CopperPilot/retro-handheld-copperpilot/case/models/copperpilot_retro_handheld_assembly.stl

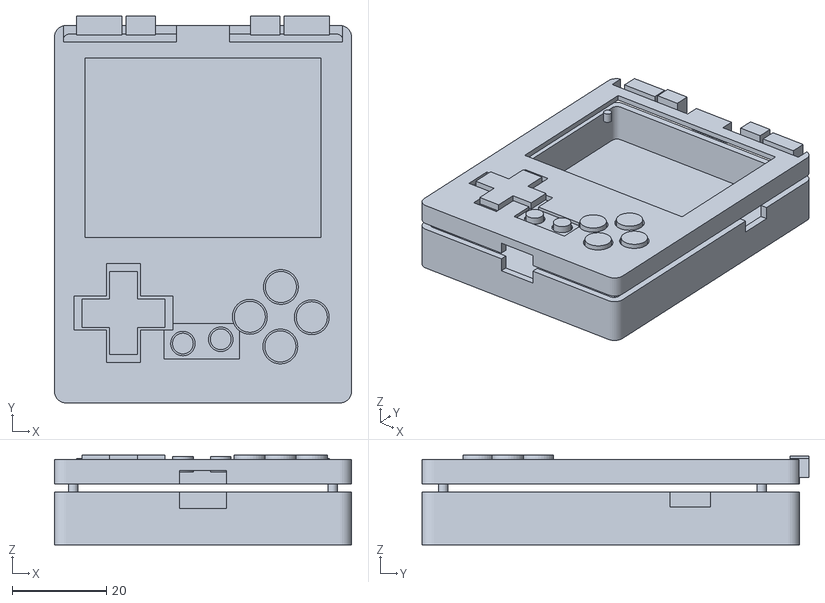
[picture p11: CAD file, 2026-10-24]
case/models/copperpilot_retro_handheld_assembly.stl
63.0 x 82.0 x 19.0
