CopperPilot/retro-handheld-copperpilot/case/models/copperpilot_retro_handheld_pcb_populated.step

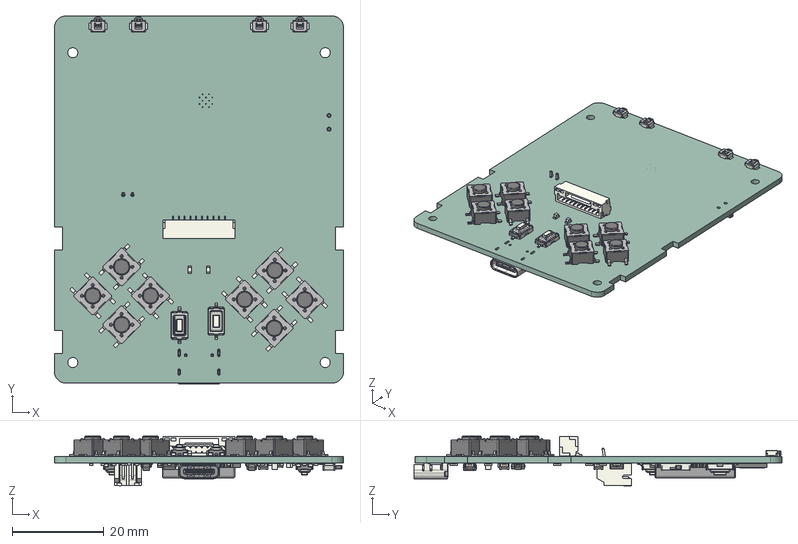
[picture p12: CAD file, 2026-10-24]
case/models/copperpilot_retro_handheld_pcb_populated.step
63.0 x 80.2 x 10.8 mm
SW_SPST_PTS645Sx43SMTR92 x 8
LED_0603_1608Metric x 2
SW_SPST_B3U-3000P x 4
JST_SM10B_GHS_TB
PTS636Sx25SMTRLFS x 4
C_0603_1608Metric x 9
R_0603_1608Metric x 29
C_0805_2012Metric x 6
R_0805_2012Metric
SOT-23 x 2
D_SOD-123
SOT-23-5 x 2
USB_C_Receptacle_16P_TopMnt_Horizontal_GCT_USB4105-xx-A
SOT-23-6
JST_S2B_PH_K
ESP32-S3-WROOM-1
Fusion_sp
copperpilot-retro-handheld_PCB
