CopperPilot/retro-handheld-copperpilot/case/models/buttons_dpad_abxy_sest_shoulders.stl

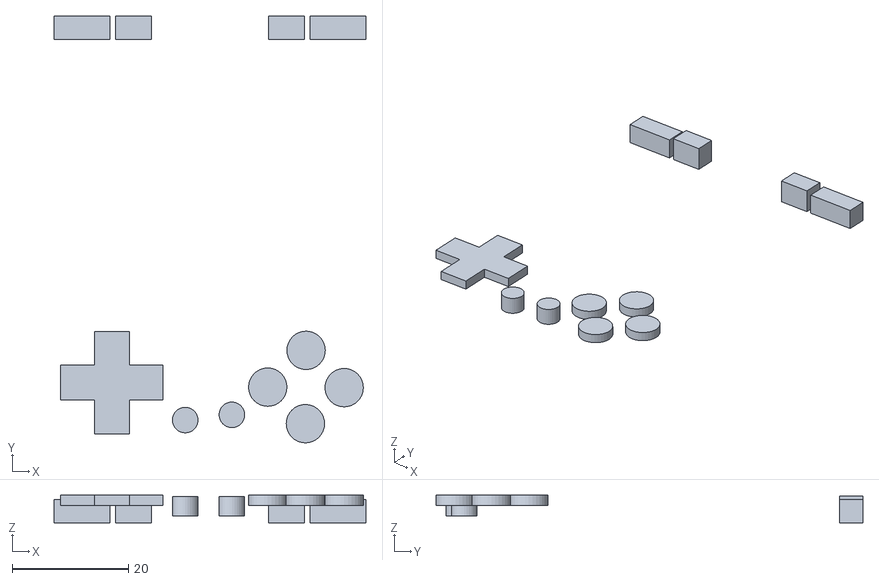
[picture p13: CAD file, 2026-10-24]
case/models/buttons_dpad_abxy_sest_shoulders.stl
53.6 x 73.3 x 4.75
