CopperPilot/retro-handheld-copperpilot/case/models/case_rear_grooved.stl

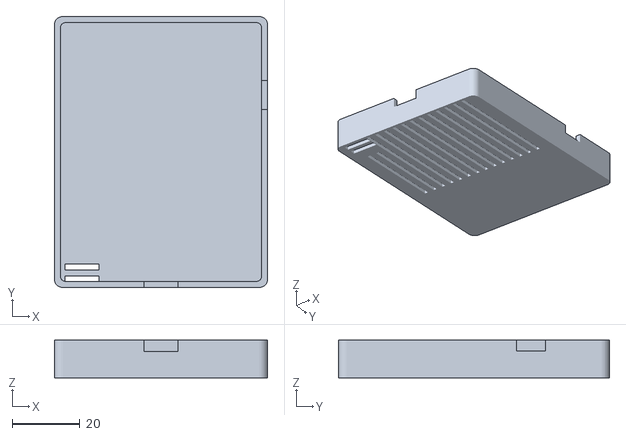
[picture p14: CAD file, 2026-10-24]
case/models/case_rear_grooved.stl
63.0 x 80.0 x 11.2
