CopperPilot/retro-handheld-copperpilot/case/models/case_battery_door.stl

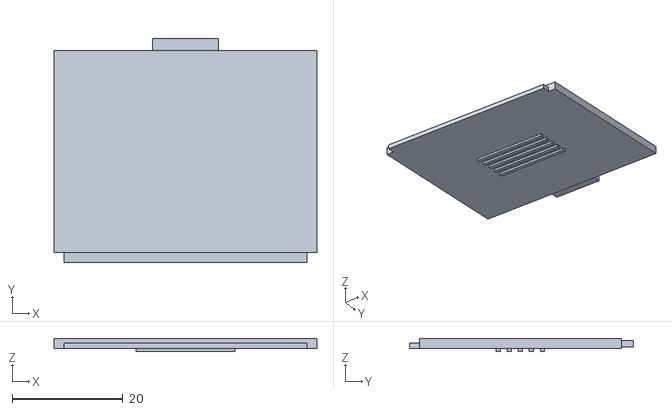
[picture p15: CAD file, 2026-10-24]
case/models/case_battery_door.stl
47.6 x 40.6 x 2.30
