CopperPilot/retro-handheld-copperpilot/case/models/case_front_bezel.stl

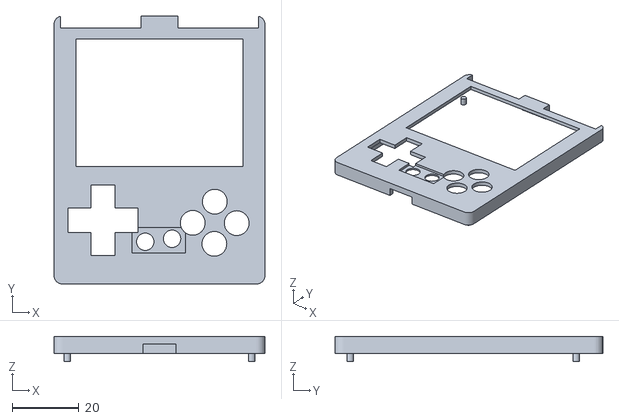
[picture p16: CAD file, 2026-10-24]
case/models/case_front_bezel.stl
63.0 x 80.0 x 7.60
