CopperPilot/retro-handheld-copperpilot/(list of files, cad)

Other CAD files:
case/models/gameboy_pcb_populated.step
case/models/copperpilot_retro_handheld_pcb_populated.stl
