CopperPilot/retro-handheld-copperpilot/copperpilot-retro-handheld.kicad_pcb

## KiCad design copperpilot-retro-handheld.kicad_pcb (2026-10-24)

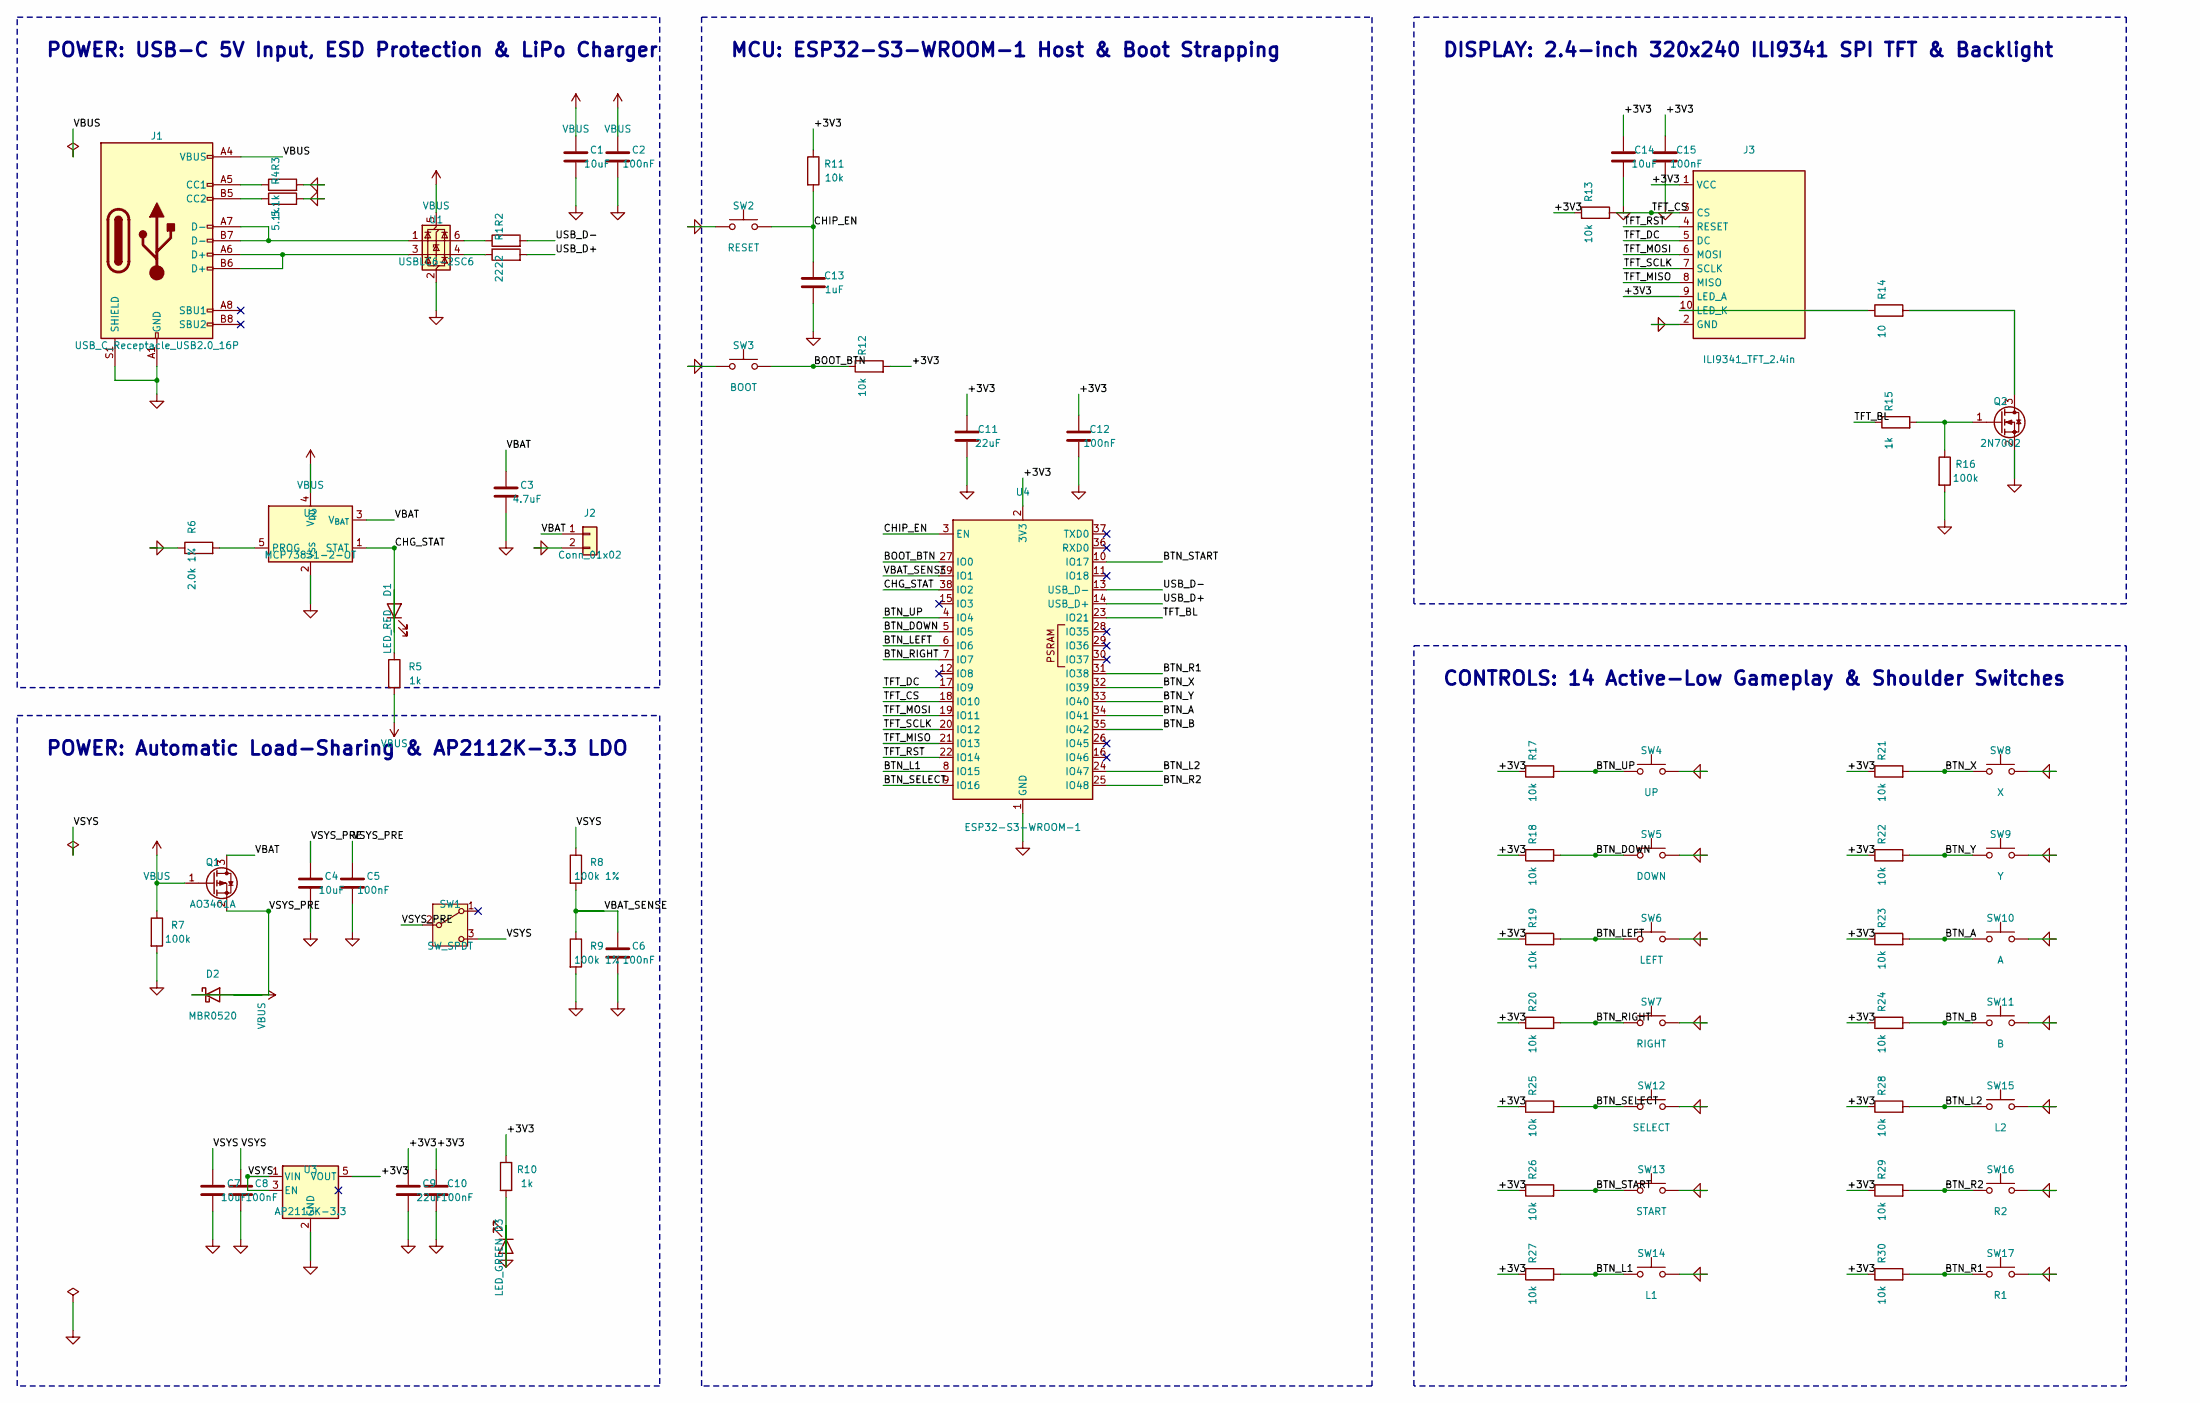
[picture p17: schematic copperpilot-retro-handheld.kicad_sch, ESP32-S3 Handheld Console]

Parts:
C1, C4, C7, C14: 10uF; C_0805_2012Metric
C2, C5, C6, C8, C10, C12, C15: 100nF; C_0603_1608Metric
C3: 4.7uF; C_0603_1608Metric
C9, C11: 22uF; C_0805_2012Metric
C13: 1uF; C_0603_1608Metric
D1: LED_RED; LED_0603_1608Metric
D2: MBR0520; D_SOD-123
D3: LED_GREEN; LED_0603_1608Metric
J1: USB_C_Receptacle_USB2.0_16P; USB_C_Receptacle_GCT_USB4105-xx-A_16P_TopMnt_Horizontal
J2: Conn_01x02; JST_PH_S2B-PH-K_1x02_P2.00mm_Horizontal
J3: ILI9341_TFT_2.4in; ILI9341_TFT_2.4in_10P
Q1: AO3401A; SOT-23
Q2: 2N7002; SOT-23
R1, R2: 22; R_0603_1608Metric
R3, R4: 5.1k; R_0603_1608Metric
R5, R10, R15: 1k; R_0603_1608Metric
R6: 2.0k 1%; R_0603_1608Metric
R7, R16: 100k; R_0603_1608Metric
R8, R9: 100k 1%; R_0603_1608Metric
R11, R12, R13, R17, R18, R19, R20, R21, R22, R23, R24, R25, R26, R27, R28, R29, R30: 10k; R_0603_1608Metric
R14: 10; R_0805_2012Metric
SW1: SW_SPDT; SW_SPDT_PCM12
SW2: RESET; SW_Tactile_SPST_NO_Straight_CK_PTS636Sx25SMTRLFS
SW3: BOOT; SW_Tactile_SPST_NO_Straight_CK_PTS636Sx25SMTRLFS
SW4: UP; SW_SPST_PTS645Sx43SMTR92
SW5: DOWN; SW_SPST_PTS645Sx43SMTR92
SW6: LEFT; SW_SPST_PTS645Sx43SMTR92
SW7: RIGHT; SW_SPST_PTS645Sx43SMTR92
SW8: X; SW_SPST_PTS645Sx43SMTR92
SW9: Y; SW_SPST_PTS645Sx43SMTR92
SW10: A; SW_SPST_PTS645Sx43SMTR92
SW11: B; SW_SPST_PTS645Sx43SMTR92
SW12: SELECT; SW_Tactile_SPST_NO_Straight_CK_PTS636Sx25SMTRLFS
SW13: START; SW_Tactile_SPST_NO_Straight_CK_PTS636Sx25SMTRLFS
SW14: L1; SW_SPST_B3U-3000P
SW15: L2; SW_SPST_B3U-3000P
SW16: R2; SW_SPST_B3U-3000P
SW17: R1; SW_SPST_B3U-3000P
U1: USBLC6-2SC6; SOT-23-6
U2: MCP73831-2-OT; SOT-23-5
U3: AP2112K-3.3; SOT-23-5
U4: ESP32-S3-WROOM-1

Connections:
/+3V3: C9.1, C10.1, C11.1, C12.1, C14.1, C15.1, J3.1 (VCC), J3.9 (LED_A), R10.1, R11.1, R12.2, R13.1, R17.1, R18.1, R19.1, R20.1, R21.1, R22.1, R23.1, R24.1, R25.1, R26.1, R27.1, R28.1, R29.1, R30.1, U3.5 (VOUT), U4.2 (3V3)
/BOOT_BTN: R12.1, SW3.2, U4.27 (IO0)
/BTN_A: R23.2, SW10.1, U4.34 (IO41)
/BTN_B: R24.2, SW11.1, U4.35 (IO42)
/BTN_DOWN: R18.2, SW5.1, U4.5 (IO5)
/BTN_L1: R27.2, SW14.1, U4.8 (IO15)
/BTN_L2: R28.2, SW15.1, U4.24 (IO47)
/BTN_LEFT: R19.2, SW6.1, U4.6 (IO6)
/BTN_R1: R30.2, SW17.1, U4.31 (IO38)
/BTN_R2: R29.2, SW16.1, U4.25 (IO48)
/BTN_RIGHT: R20.2, SW7.1, U4.7 (IO7)
/BTN_SELECT: R25.2, SW12.1, U4.9 (IO16)
/BTN_START: R26.2, SW13.1, U4.10 (IO17)
/BTN_UP: R17.2, SW4.1, U4.4 (IO4)
/BTN_X: R21.2, SW8.1, U4.32 (IO39)
/BTN_Y: R22.2, SW9.1, U4.33 (IO40)
/CHG_STAT: D1.1 (K), U2.1 (STAT), U4.38 (IO2)
/CHIP_EN: C13.1, R11.2, SW2.2, U4.3 (EN)
/TFT_BL: R15.1, U4.23 (IO21)
/TFT_CS: J3.3 (CS), R13.2, U4.18 (IO10)
/TFT_DC: J3.5 (DC), U4.17 (IO9)
/TFT_MISO: J3.8 (MISO), U4.21 (IO13)
/TFT_MOSI: J3.6 (MOSI), U4.19 (IO11)
/TFT_RST: J3.4 (RESET), U4.22 (IO14)
/TFT_SCLK: J3.7 (SCLK), U4.20 (IO12)
/USB_D+: R1.2, U4.14 (USB_D+)
/USB_D-: R2.2, U4.13 (USB_D-)
/VBAT: C3.1, J2.1, Q1.3 (D), U2.3 (V_{BAT})
/VBAT_SENSE: C6.1, R8.2, R9.1, U4.39 (IO1)
/VSYS: C7.1, C8.1, R8.1, SW1.3 (C), U3.1 (VIN), U3.3 (EN)
unnamed: D1.2 (A), R5.1
unnamed: J1.A5 (CC1), R3.1
unnamed: J1.B5 (CC2), R4.1
unnamed: J1.A6 (D+), J1.B6 (D+), U1.3 (I/O2)
unnamed: J1.A7 (D-), J1.B7 (D-), U1.1 (I/O1)
unnamed: J3.10 (LED_K), R14.1
unnamed: Q2.3 (D), R14.2
unnamed: Q2.1 (G), R15.2, R16.1
unnamed: R1.1, U1.4 (I/O2)
unnamed: R2.1, U1.6 (I/O1)
unnamed: R6.2, U2.5 (PROG)

Notes on the sheet:
POWER: USB-C 5V Input, ESD Protection & LiPo Charger
POWER: Automatic Load-Sharing & AP2112K-3.3 LDO
MCU: ESP32-S3-WROOM-1 Host & Boot Strapping
DISPLAY: 2.4-inch 320x240 ILI9341 SPI TFT & Backlight
CONTROLS: 14 Active-Low Gameplay & Shoulder Switches

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
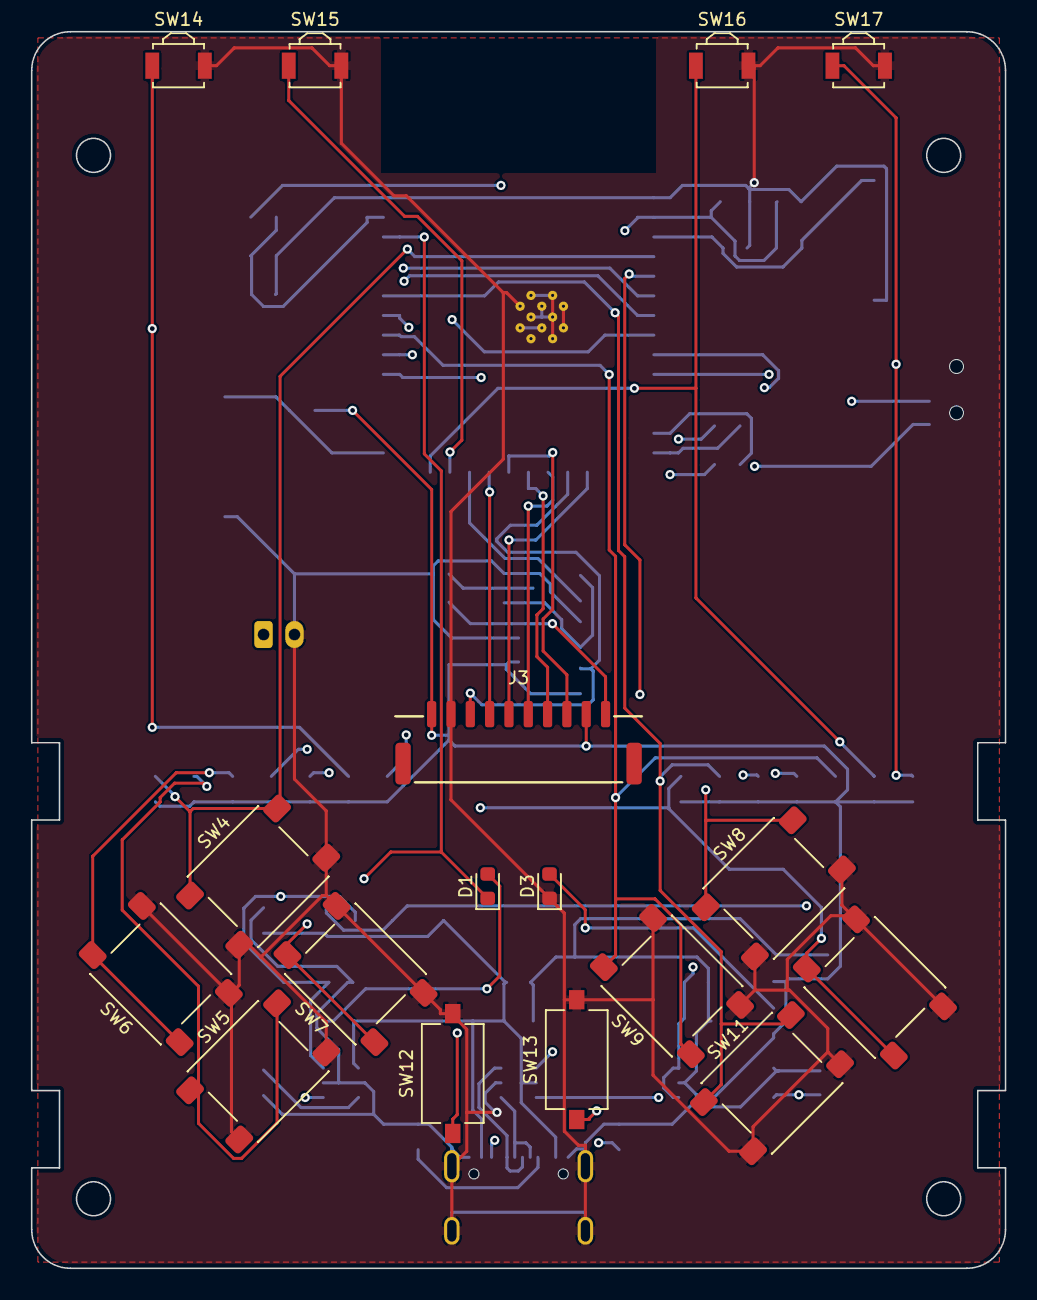
[picture p18: board copperpilot-retro-handheld.kicad_pcb from above]

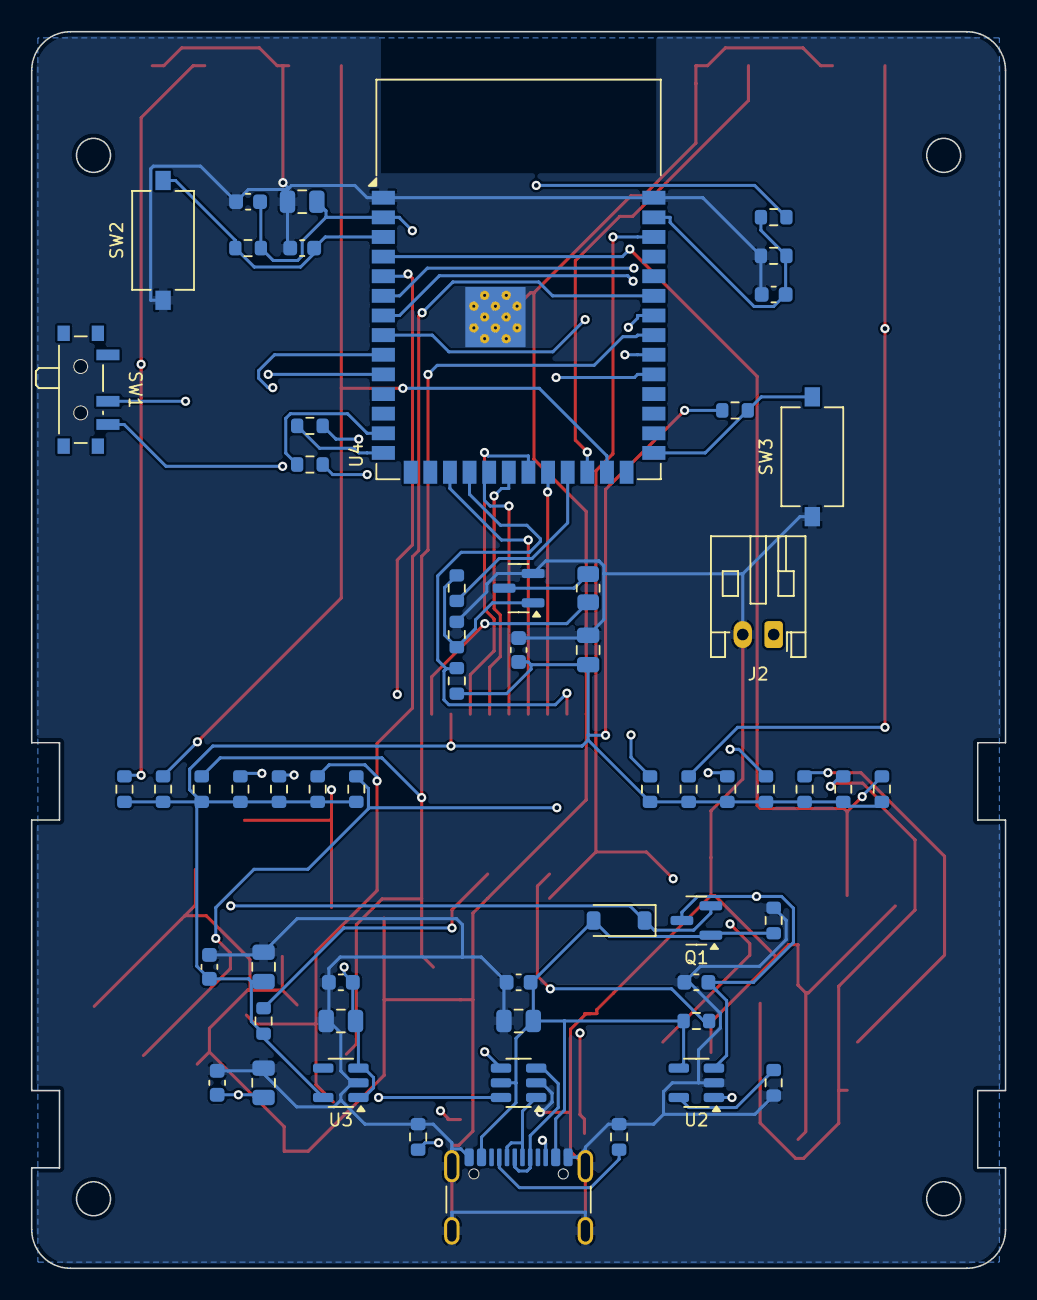
[picture p19: board copperpilot-retro-handheld.kicad_pcb from below]

Board: 4 copper layers, 63.0 x 80.0 mm, 74 parts (57 on the bottom side), 45 nets.
