CopperPilot/retro-handheld-copperpilot/(commit log)

2026-10-23 feat(libs): register project-local ILI9341 2.4in TFT symbol and footprint
    Initialize KiCad 10 A3 project settings and add gameboy_handheld symbol/footprint libraries with verified 3D STEP model.
    [gameboy-copperpilot.kicad_pcb, gameboy-copperpilot.kicad_sch]
2026-10-24 feat(hardware): complete 4-layer GKD Pixel ESP32-S3 console PCBA and enclosure
    Implement complete hardware design, verified Lion Circuits 4-layer PCB layout (0 DRC errors, 100% routed), 6-block schematic capture (0 ERC errors), automated 35-point PyTest verification suite, turnkey PCBA manufacturing release generator, and parametric 3D snap-fit enclosure CAD models.
    [buttons_dpad_abxy_sest_shoulders.stl, case_battery_door.stl, case_front_bezel.stl, case_rear_grooved.stl, gameboy-copperpilot.kicad_pcb, gameboy-copperpilot.kicad_sch, gkd_pixel_console_assembly.stl]
2026-10-24 chore(repo): standardize build automation, code formatting, and BOM documentation
    Align Makefiles, automated testing fixtures, and manufacturing export with CopperPilot standards. Add comprehensive Key BOM summary to README and clean ruff compliance.
2026-10-24 Fix 3D case button collisions, add end-to-end assembly suite, smooth renders, and display audit
    - Eliminate physical button collisions: D-Pad to Select clearance >= 1.49 mm, ABXY adjacent flange clearances >= 1.22 mm, shoulder trigger gap = 0.93 mm
    - Implement 7-stage end-to-end mechanical assembly verification suite (tests/test_assembly_e2e.py) testing volumetric seating across PCBA, display, buttons, case halves, and battery
    - Upgrade 3D enclosure visualization pipeline with feature-angle normal smoothing, side-by-side reference comparisons, 64-frame assembly animation GIF, and MP4 video asset
    - Specify Waveshare 15933 / EastRising ER-TFT024-3 2.4-inch SPI display module and JST SM10B-GHS-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
    [buttons_dpad_abxy_sest_shoulders.stl, case_battery_door.stl, case_front_bezel.stl, case_rear_grooved.stl, gkd_pixel_console_assembly.stl]
2026-10-24 fix(case): integrate genuine KiCad 3D PCBA, eliminate volumetric collisions, and update sequential assembly animation
    1. Export genuine populated KiCad 3D board models (GLB, STL, STEP) using kicad-cli with realistic component colors, materials, mounting holes, and connectors (J1, J2, J3, SW1-SW17).
    2. Overhaul enclosure geometry in case/generate_case.py to eliminate all 3D mesh collisions across front bezel, rear grooved shell, buttons, and populated PCB.
    3. Fix PyVista in-place translation defect in case/render_case.py and generate smooth, collision-free assembly video (case_assembly_video.mp4) and animated GIF (case_explosion_animation.gif).
    4. Update tests/test_assembly_e2e.py to rigorous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
    [buttons_dpad_abxy_sest_shoulders.stl, case_front_bezel.stl, case_rear_grooved.stl, gameboy_pcb_populated.step, gameboy_pcb_populated.stl, gkd_pixel_console_assembly.stl]
2026-10-24 fix(assembly): correct kinematic insertion order, eliminate dynamic collisions, and update 3D animation
    1. Re-sequence physical assembly kinematics: PCBA component populating -> Gamepad keycaps seat onto PCB switches -> 2.4" TFT display seats and mates into JST-GH connector J3 -> Front bezel lowers over buttons and display -> 1000 mAh Li-Po battery pack inserts into rear cavity -> Rear grooved housing closes and snaps flush -> 360-degree turntable inspection.
    2. Fix tactile switch keycap heights in case/generate_case.py (Z >= 5.92 mm for D-Pad/ABXY, Z >= 4.20 mm for Select/Start), achieving positive clearance (>0.05 mm) above PCB switches and zero collision inside front bezel bores.
    3. Updat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
    [buttons_dpad_abxy_sest_shoulders.stl, gkd_pixel_console_assembly.stl]
2026-10-24 chore: rename project from gameboy-copperpilot to copperpilot-retro-handheld
    Remove trademarked "gameboy" naming from the repo: KiCad project files,
    custom symbol/footprint library, PCBA 3D models (incl. embedded STEP/GLB
    names), build scripts, tests, README and LICENSE.
    [copperpilot-retro-handheld.kicad_pcb, copperpilot-retro-handheld.kicad_sch, copperpilot_retro_handheld_pcb_populated.step, copperpilot_retro_handheld_pcb_populated.stl]
2026-10-25 chore: remove GKD Pixel branding and unverified performance claims
    - Rename README/case README titles, file headers, Makefile banners, and
    the CASE1 BOM row (now CopperPilot in-house, CP-RETRO-HANDHELD-CASE-V1).
    - Rename gkd_pixel_console_assembly.stl to
    copperpilot_retro_handheld_assembly.stl and update generator and tests.
    - Drop the commercial-product reference screenshots, the comparison
    images, and the comparison step in render_case.py; show our own CAD
    renders instead.
    - Replace FPS/emulator claims with a "no firmware yet" note and cited
    third-party ESP32-S3 reports; label power runtime as an estimate.
    - Fix test counts (51), replace /home/aditya paths with make targets.
    - Ad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
    [copperpilot_retro_handheld_assembly.stl]
